Marietto2008/bbq20kbd_hw/keyboard.kicad_sch

## KiCad design keyboard.kicad_sch (2025-04-02)

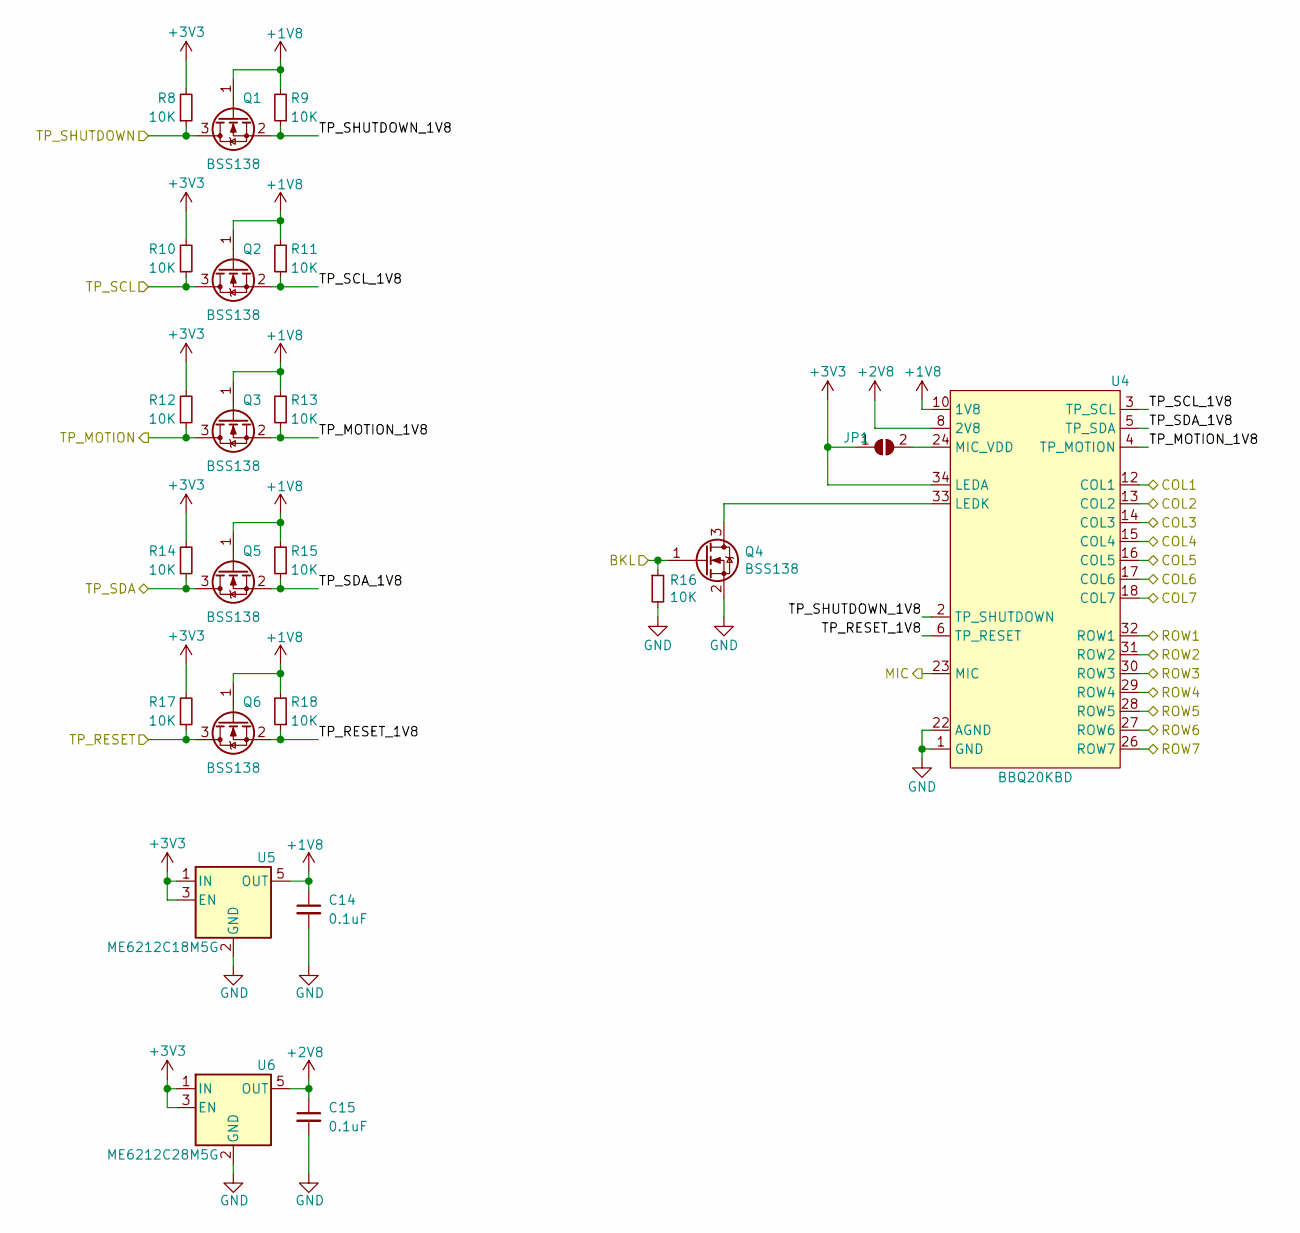
[picture p2: schematic keyboard.kicad_sch]

Parts:
C14, C15: 0.1uF; C_0603_1608Metric
JP1: SJ_MIC_VDD; SolderJumper-2_P1.3mm_Open_RoundedPad1.0x1.5mm
Q1, Q2, Q3, Q4, Q5, Q6: BSS138; SOT-23; LCSC C112239
R8, R9, R10, R11, R12, R13, R14, R15, R16, R17, R18: 10K; R_0603_1608Metric
U4: BBQ20KBD; BM20B(0.8)-40DS-0.4V; LCSC C424543
U5: ME6212C18M5G; SOT-23-5; LCSC C236669
U6: ME6212C28M5G; SOT-23-5; LCSC C427596

Connections:
+1V8: C14.1, Q1.1 (G), Q2.1 (G), Q3.1 (G), Q5.1 (G), Q6.1 (G), R9.2, R11.2, R13.2, R15.2, R18.2, U4.10 (1V8), U5.5 (OUT)
+2V8: C15.1, U4.8 (2V8), U6.5 (OUT)
+3V3: JP1.1 (A), R8.2, R10.2, R12.2, R14.2, R17.2, U4.34 (LEDA), U4.36 (LEDA), U5.1 (IN), U5.3 (EN), U6.1 (IN), U6.3 (EN)
BKL: Q4.1 (G), R16.1
COL1: U4.12 (COL1)
COL2: U4.13 (COL2)
COL3: U4.14 (COL3)
COL4: U4.15 (COL4)
COL5: U4.16 (COL5)
COL6: U4.17 (COL6)
COL7: U4.18 (COL7)
GND: C14.2, C15.2, Q4.2 (S), R16.2, U4.1 (GND), U4.7 (GND), U4.9 (GND), U4.11 (GND), U4.19 (GND), U4.20 (GND), U4.21 (GND), U4.22 (AGND), U4.25 (GND), U4.40 (GND), U5.2 (GND), U6.2 (GND)
MIC: U4.23 (MIC)
unnamed: JP1.2 (B), U4.24 (MIC_VDD)
unnamed: Q4.3 (D), U4.33 (LEDK), U4.35 (LEDK), U4.37 (LEDK)
ROW1: U4.32 (ROW1)
ROW2: U4.31 (ROW2)
ROW3: U4.30 (ROW3)
ROW4: U4.29 (ROW4)
ROW5: U4.28 (ROW5)
ROW6: U4.27 (ROW6)
ROW7: U4.26 (ROW7)
TP_MOTION: Q3.3 (D), R12.1
TP_MOTION_1V8: Q3.2 (S), R13.1, U4.4 (TP_MOTION)
TP_RESET: Q6.3 (D), R17.1
TP_RESET_1V8: Q6.2 (S), R18.1, U4.6 (TP_RESET)
TP_SCL: Q2.3 (D), R10.1
TP_SCL_1V8: Q2.2 (S), R11.1, U4.3 (TP_SCL)
TP_SDA: Q5.3 (D), R14.1
TP_SDA_1V8: Q5.2 (S), R15.1, U4.5 (TP_SDA)
TP_SHUTDOWN: Q1.3 (D), R8.1
TP_SHUTDOWN_1V8: Q1.2 (S), R9.1, U4.2 (TP_SHUTDOWN)
