Marietto2008/bbq20kbd_hw/(commit log)

2025-04-02 Migrate KiCAD version -> 1.0, update part numbers
    [bbq20_keyboard.kicad_pcb, bbq20_keyboard.kicad_sch, keyboard.kicad_sch]
2025-04-02 export JLCPCB gerbers, BOM & positioning files
    [bbq20_keyboard-B_Cu.gbl, bbq20_keyboard-B_Mask.gbs, bbq20_keyboard-B_Paste.gbp, bbq20_keyboard-B_Silkscreen.gbo, bbq20_keyboard-Edge_Cuts.gm1, bbq20_keyboard-F_Cu.gtl, bbq20_keyboard-F_Mask.gts, bbq20_keyboard-F_Paste.gtp]
